sarahjacobs/ECG_HR_Monitor/Block_Diagram.jpg

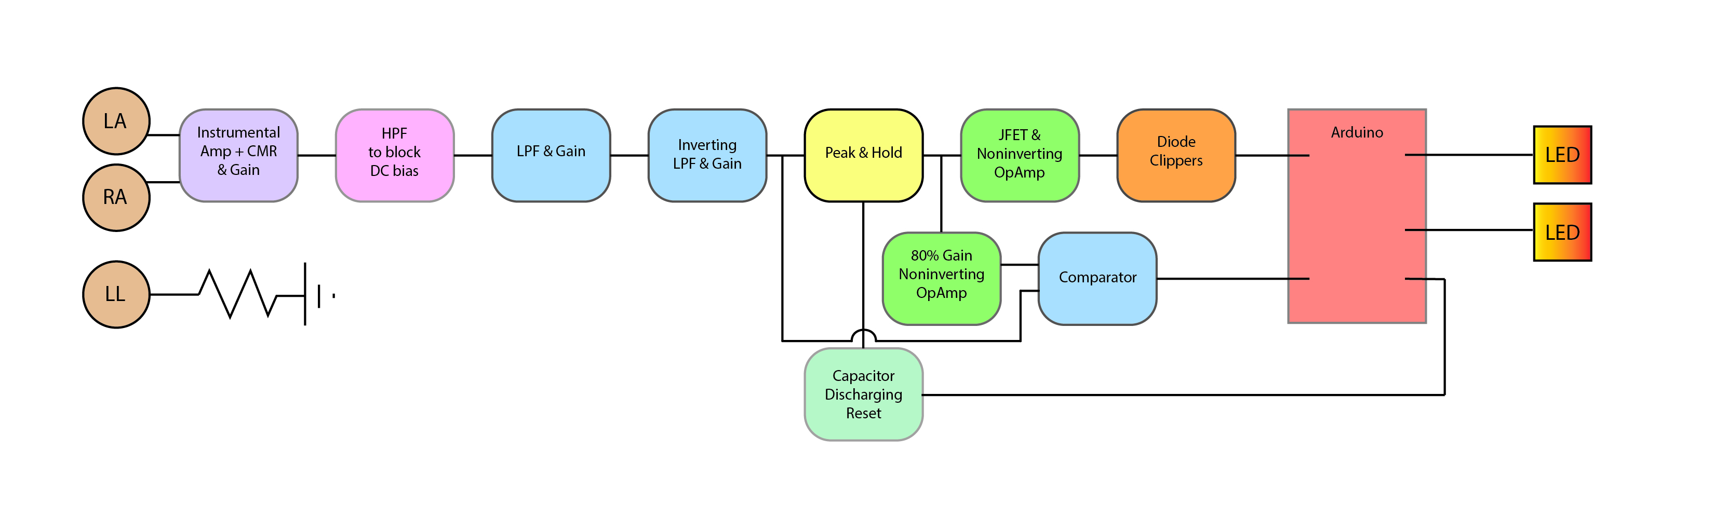
Block_Diagram.jpg
