sarahjacobs/ECG_HR_Monitor/Circuit_Schematic.png

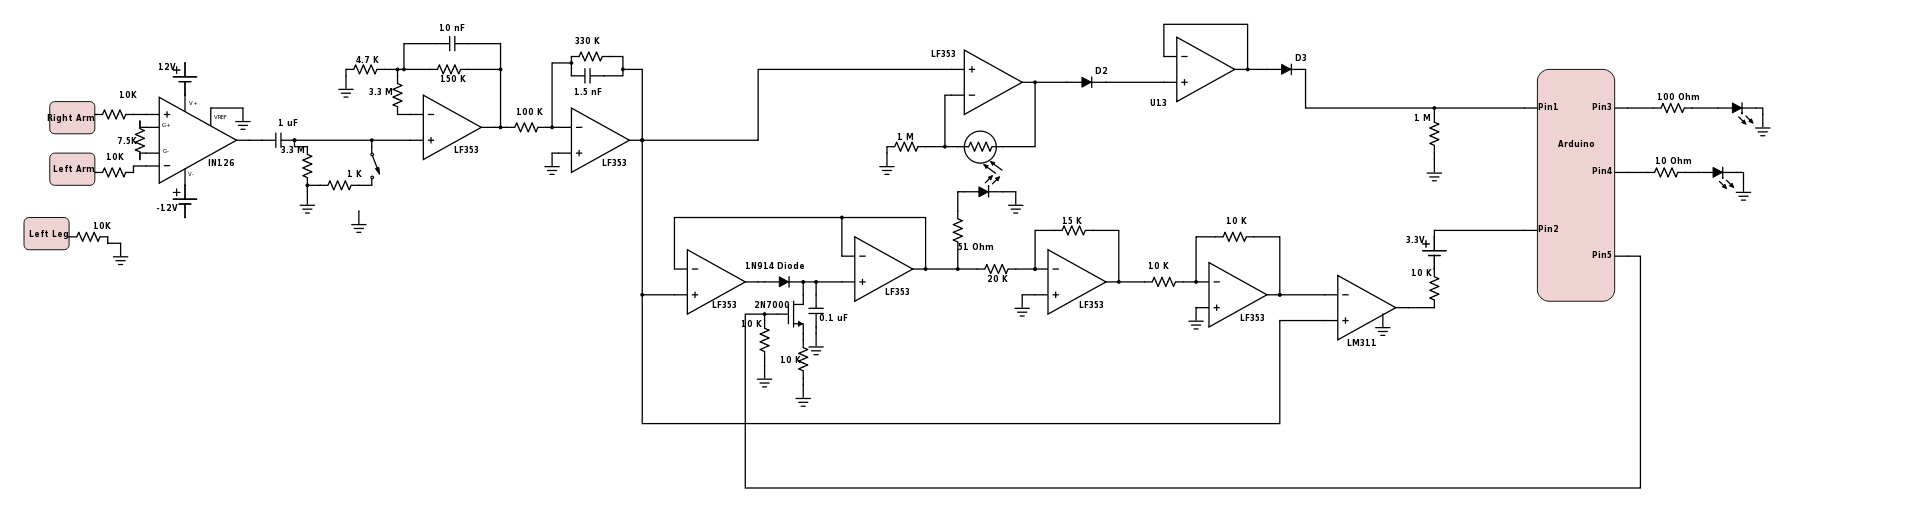
Circuit_Schematic.png
