sarahjacobs/ECG_HR_Monitor/(commit log)

2018-02-18 Added Arduino software
2018-02-19 Added bill of materials for project
    [ECG_BOM.xlsx]
2018-02-19 Added circuit schematic picture
